ChewOnThis/e2k-e3k-systems/README.md

### Repository for ENGG2000/ENGG3000 Systems team
Working on code for sensors and bridge movement

#### Project:
    Contains the Arduino acceptable Project Code

#### Documentation:
    Psuedocode and File Function Separation
    Algorithm Flow Sequence Chart {Mermaid}

### Current Working Directory:
- MidSem
    - HTML
    - Motor Control
    - Traffic Light Control
    - Street Light Control
    - Button Control
    - UltraSonic Singular
    - UltraSonic Double
    - Webpage
        - HTML
        - ESP32
    - StateMachine
    - Project
        - Full Project
