ChewOnThis/e2k-e3k-systems/Documentation/ESP Pin Mapping Notes.docx

## Pins:

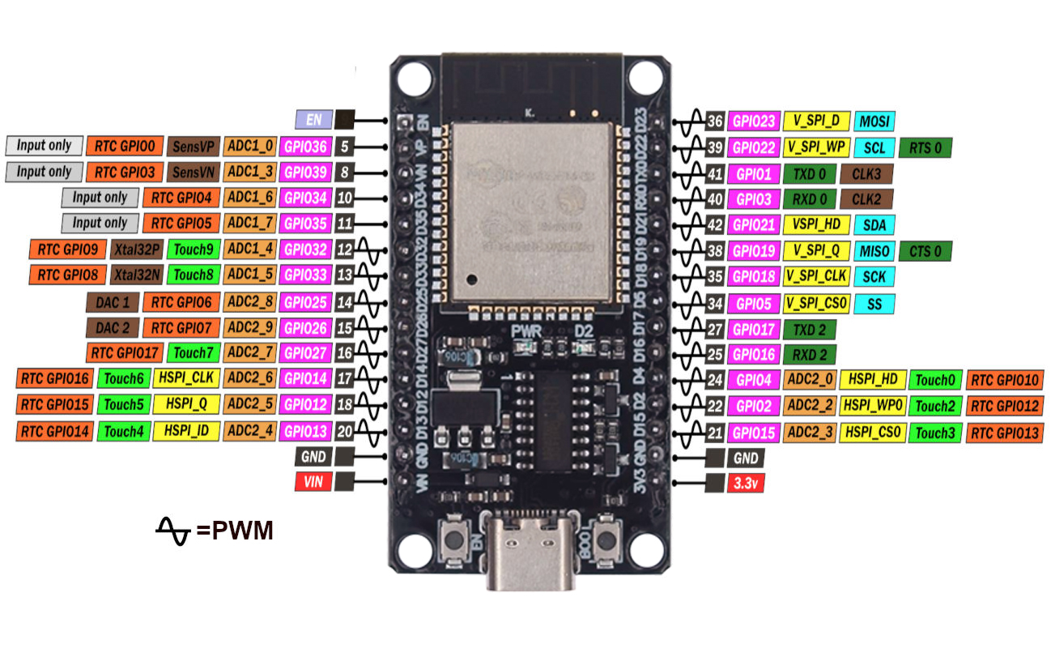
[picture p1: figure]

EN | D23
VP | D22
VN | TX0
D34 | RX0
D35 | D21
D32 | D19
D33 | D18
D25 | D5
D26 | D17
D27 | D16
D14 | D4
D12 | D2
D13 | D15
GND | GND
VIN | 3V3

Key:

| Input only (no pull-up/pull-down)
| Avoid
| Output only (onboard LED)
| ADC unavailable when Wi-fi is enabled
| State affects boot-up process

## Avoid:

- GPIO6
- GPIO7
- GPIO8
- GPIO9
- GPIO10
- GPIO11
  - Click for explanation (https://randomnerdtutorials.com/esp32-pinout-reference-gpios/)
- RX0
- TX0
  - Serial debugger pins
- GPIO2
  - LED on board acts as a very strong pull-down, since we’re using a pull-up approach for all buttons, this pin should only be used for outputs
  - Additionally, Chris uses the LED for debugging so try to avoid unless absolutely necessary
- GPIO5
- GPIO12
- GPIO15
  - Click for explanation (https://lastminuteengineers.com/esp32-pinout-reference/)

## Peripheral needs (MVP):

- Motor driver
  - 2x PWM channels (any GPIO pin)
- LEDS
  - 5x GPIO
- Switches
  - 3x GPIO (with pull-ups)

## Peripheral needs (full design):

- Motor driver
  - 2x PWM channels (any GPIO pin)
- LEDS
  - 6x GPIO
- Switches
  - 4x GPIO (with pull-ups)
- Buzzer
  - 1x GPIO
- Ultrasonics
  - 2x Inputs receive pins
  - 2x GPIO trigger pins

# Pins in use:

Connected to | Pins | | Connected to
| EN | D23 | E-Stop
Ultrasonic echo 2 | VP | D22 | Start button
Ultrasonic echo 1 | VN | TX0
Light sensor | D34 | RX0
| D35 | D21 | Status light
Ultrasonic trigger 2 | D32 | D19 | Piezo buzzer
Ultrasonic trigger 1 | D33 | D18 | Streetlight MOSFET
Car red | D25 | D5 | Driver board En
Car yellow | D26 | D17 | Limit switch 2
Car green | D27 | D16 | Limit switch 1
Boat red | D14 | D4
Driver board In2 | D12 | D2
Driver board In1 | D13 | D15
Driver board / 5V regulator Gnd | GND | GND
5V regulator | VIN | 3V3
