ChewOnThis/e2k-e3k-systems/Documentation/MVP Schematic Clean.png

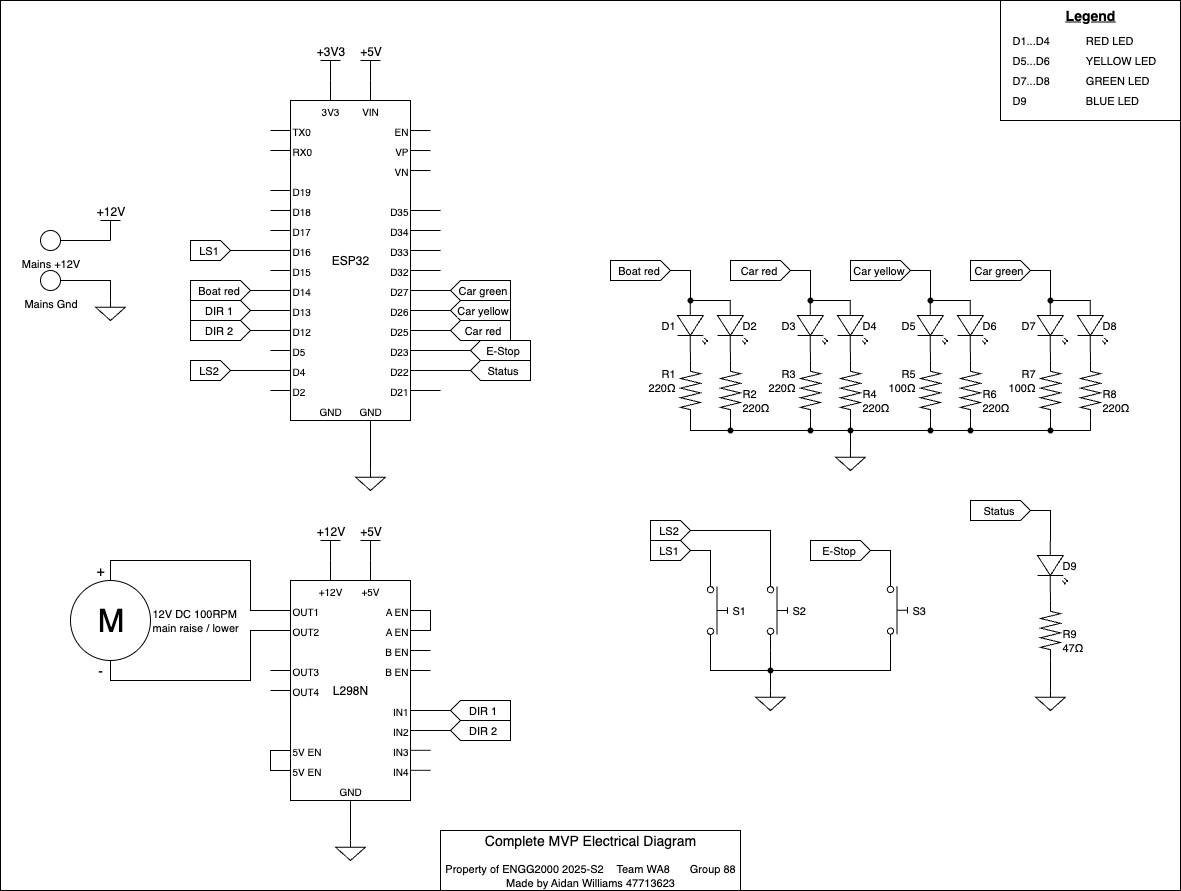
Documentation/MVP Schematic Clean.png
