ChewOnThis/e2k-e3k-systems/Documentation/Whole Bridge Schematic.png

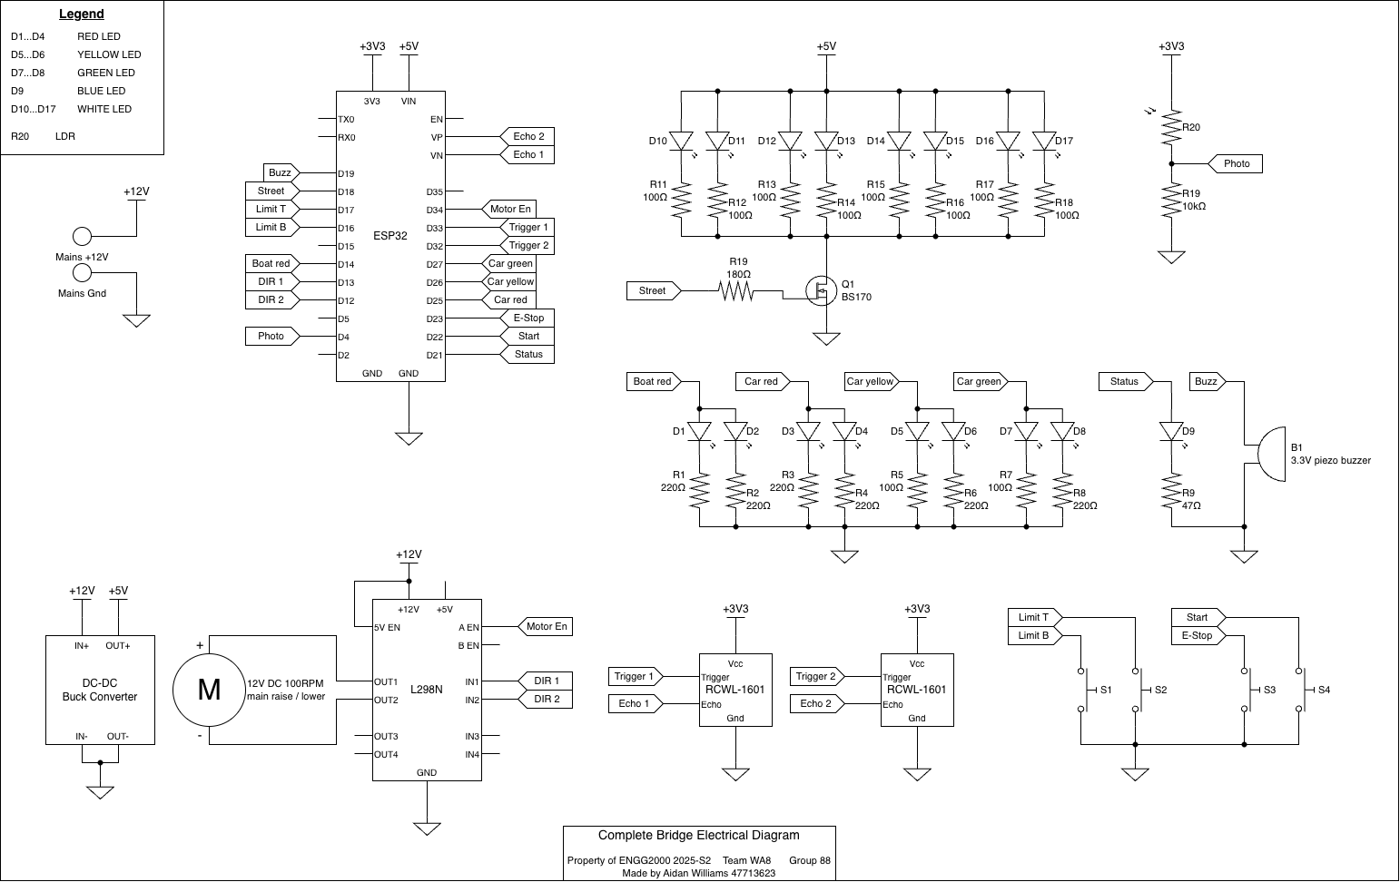
Documentation/Whole Bridge Schematic.png
