ChewOnThis/e2k-e3k-systems/psuedocode/ControlBridge/Diagrams/bridge states.png

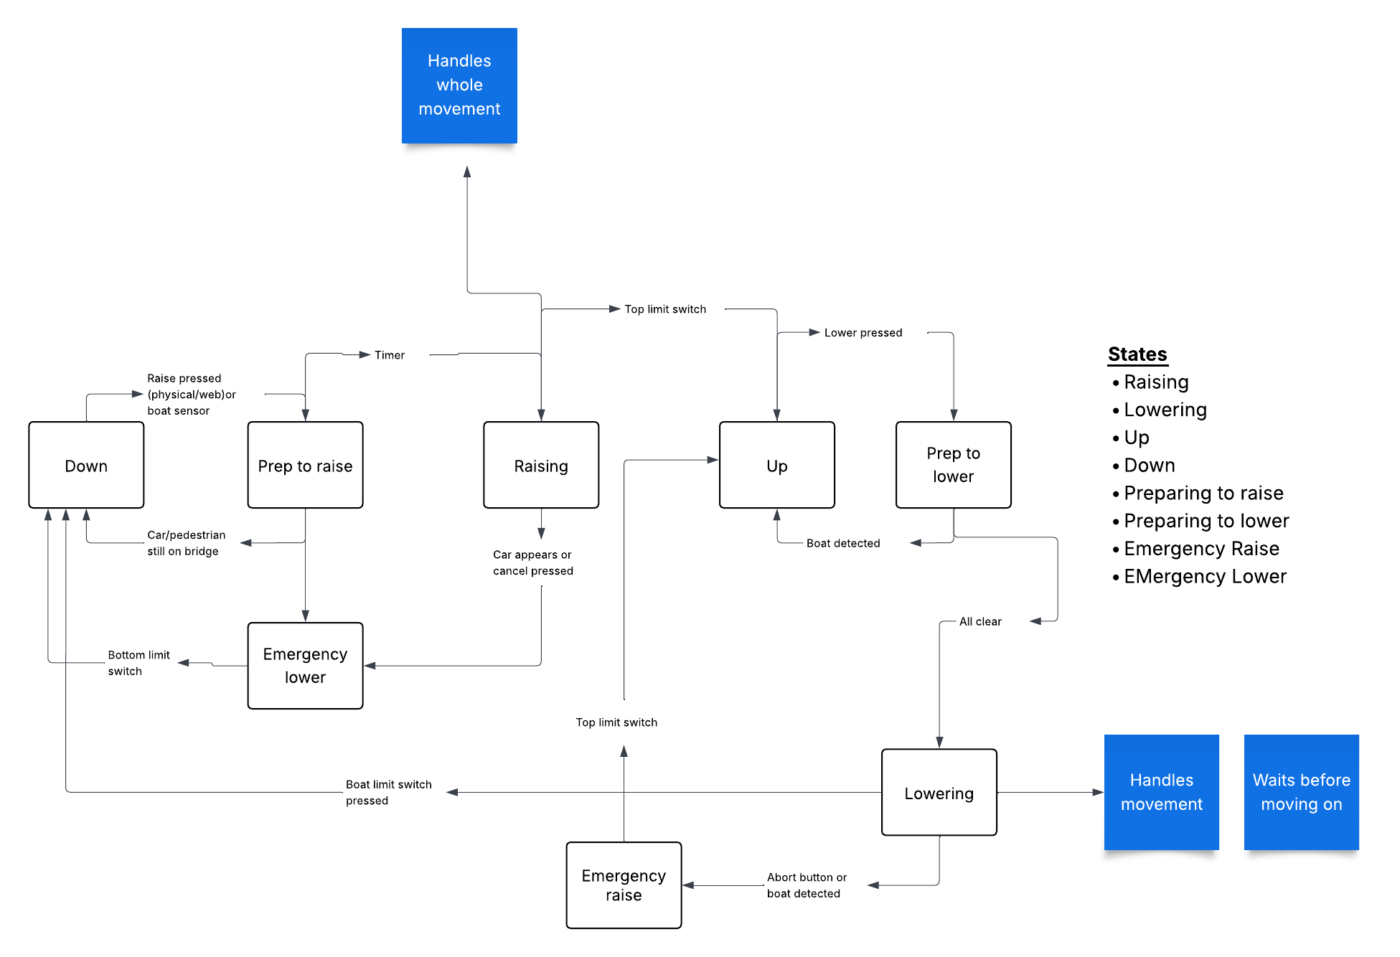
psuedocode/ControlBridge/Diagrams/bridge states.png
