ChewOnThis/e2k-e3k-systems/psuedocode/ControlBridge/Diagrams/down state.png

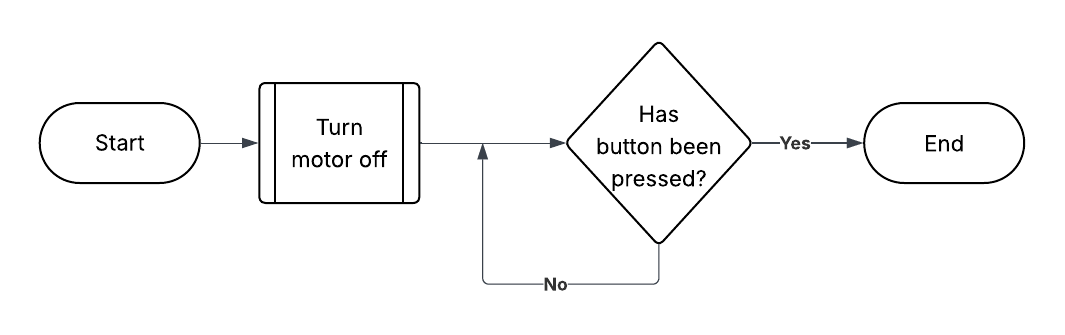
psuedocode/ControlBridge/Diagrams/down state.png
