ChewOnThis/e2k-e3k-systems/psuedocode/ControlBridge/Diagrams/emergency lowering state.png

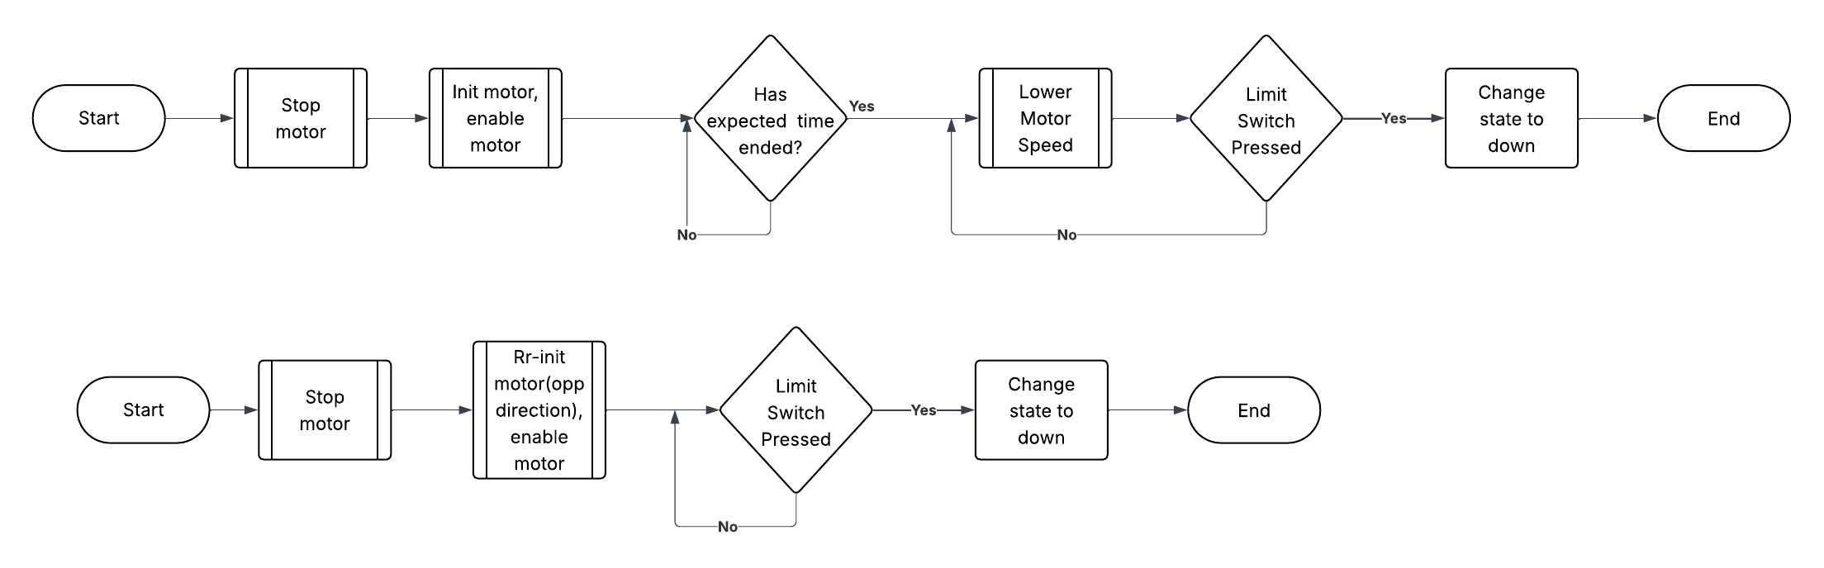
psuedocode/ControlBridge/Diagrams/emergency lowering state.png
