ChewOnThis/e2k-e3k-systems/psuedocode/ControlBridge/Diagrams/emergency raising state.png

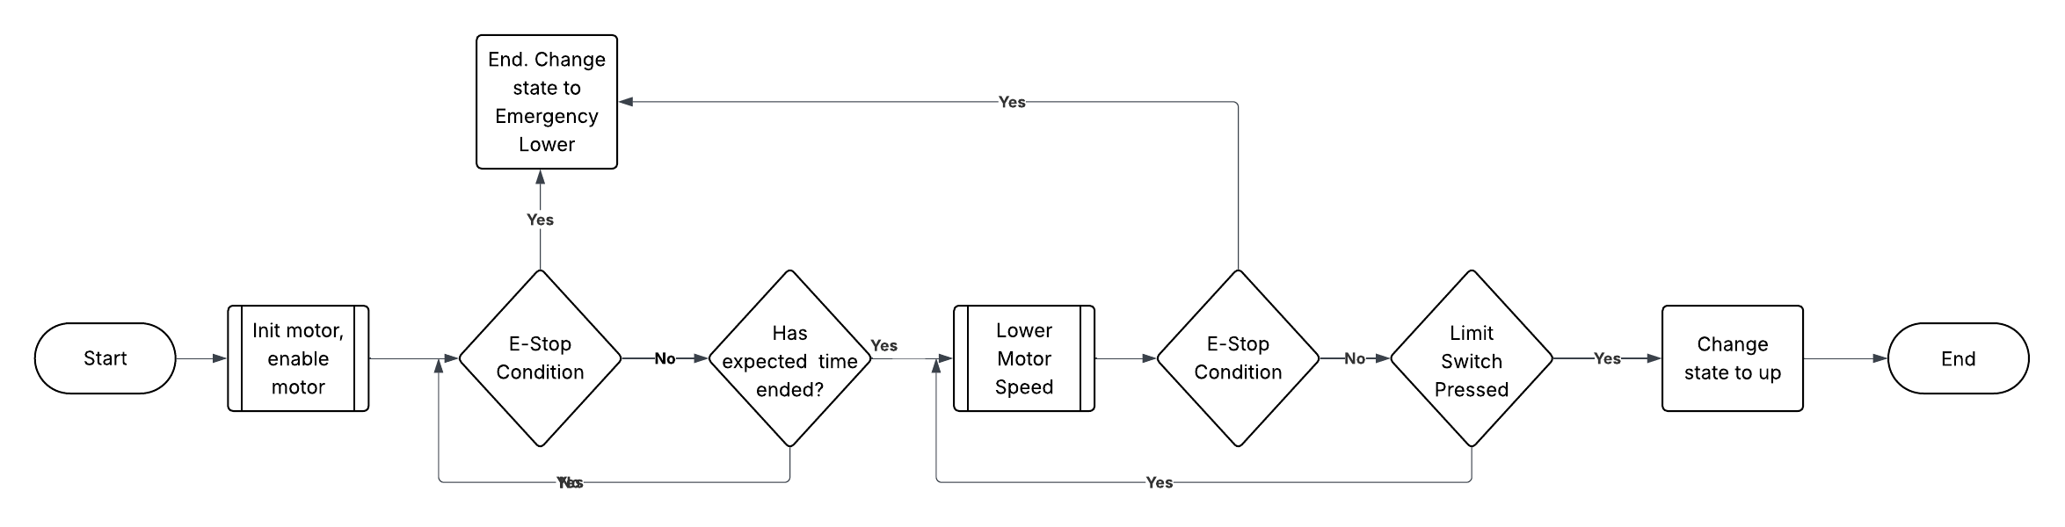
psuedocode/ControlBridge/Diagrams/emergency raising state.png
