ChewOnThis/e2k-e3k-systems/psuedocode/ControlBridge/Diagrams/prep to raise state.png

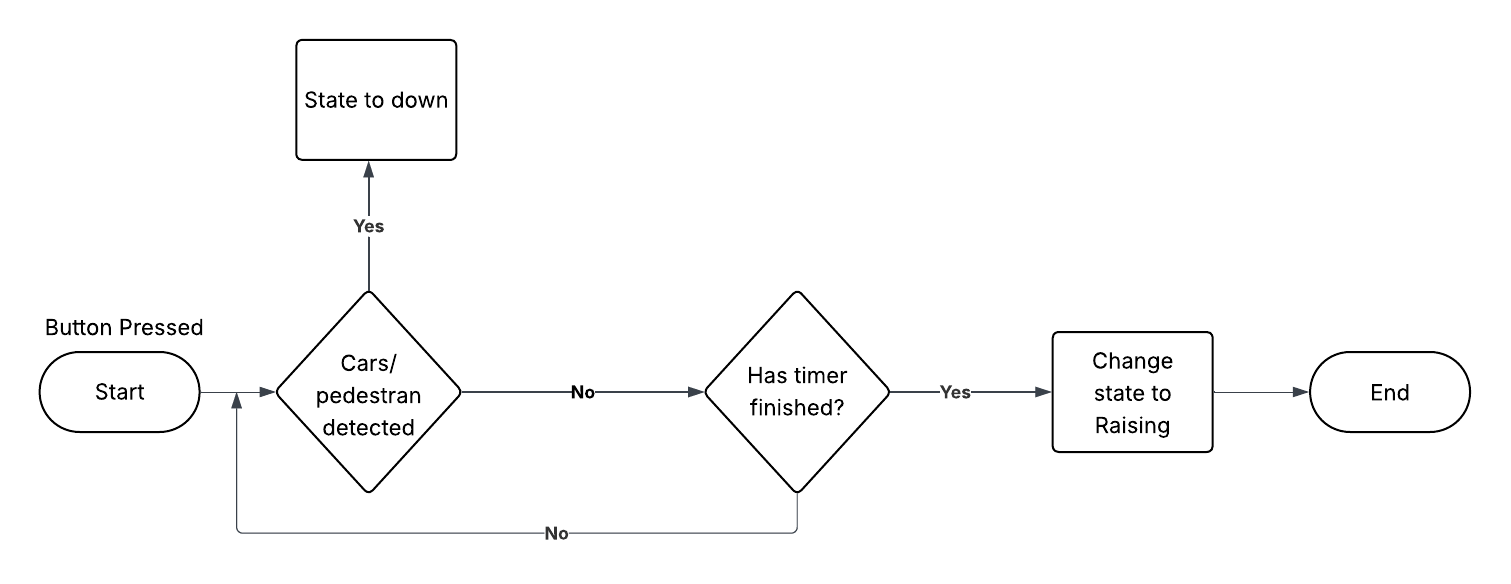
psuedocode/ControlBridge/Diagrams/prep to raise state.png
