ChewOnThis/e2k-e3k-systems/psuedocode/ControlBridge/Diagrams/Up State.png

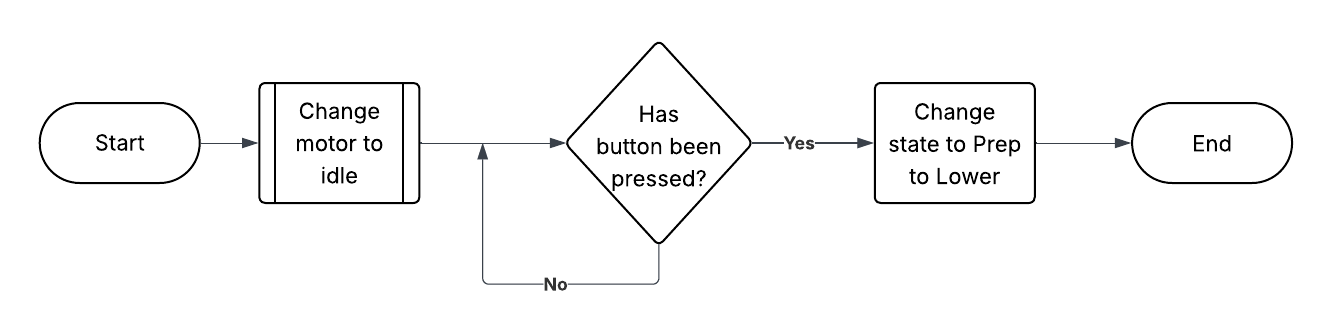
psuedocode/ControlBridge/Diagrams/Up State.png
