ChewOnThis/e2k-e3k-systems/testing/WebServer Testing/WebServer/GridLayout.html

# Team WA8 Single Leaf Bridge

## Wireless Control Panel

Team WA8 Wifi Control Web-Based GUI for AP Access to the ESP32 Microcontroller for Controller over subsystems of the ENGG2000/3000 Scale Model Bridge Design/Contruction Project

GitHub Repository (https://github.com/ChewOnThis/e2k-e3k-systems)
