ChewOnThis/e2k-e3k-systems/MidSem/Project/main.h

#ifndef MAIN_H
#define MAIN_H

#include <Arduino.h>
#include <TimerOne.h>
#include "WebPage.h"
#include "StateMachine.h"
#include "DCMotor.h"
#include "SonicSensor.h"
#include "TrafficLight.h"


#define Pin_Enable           5
#define Pin_DIR2            12
#define Pin_DIR1            13 
#define Pin_BoatLight       14
#define Pin_LS_Bottom       16
#define Pin_LS_Top          17
#define Pin_Street          18
#define Pin_Status          21
#define Pin_Buzzer          19
#define Pin_BridgeMove      22
#define Pin_EStop           23
#define Pin_TrafficRed      25
#define Pin_TrafficYellow   26
#define Pin_TrafficGreen    27
#define Pin_SonicTrigger_2  32
#define Pin_SonicTrigger_1  33
#define Pin_PhotoCell       34
#define Pin_SonicEcho_2     36
#define Pin_SonicEcho_1     39

#define MotorSpeed_Fast 
#define MotorSpeed_Slow

#define WebServer_PollingRate   1000 //ms
#define WebServer_SSID          "ESP32WA8"
#define WebServer_Password      "12345678"

extern TrafficModule traffic;
extern Sonic sonic1;
extern Sonic sonic2;
extern Motor motor ;
void initPins();
void disableMotor();
void initInterrupts();
void streetLights();
void sonics();
extern bridgeState currentState;
extern bool Manual;
extern bool EStop;
extern bool streetLightOn;
extern bool ultrasonics;
extern double sonic1Dist_cm;
extern double sonic2Dist_cm;

const int detection_distance = 30;


#endif
