ChewOnThis/e2k-e3k-systems/MidSem/Project/DCMotor.h

#ifndef DCMOTOR_H
#define DCMOTOR_H

#include <Arduino.h>

class Motor {
    private:
        uint8_t DrivePin;
        uint8_t DirectionPin;
        uint8_t EnablePin;
    public:
        Motor(uint8_t drive, uint8_t dir, uint8_t en);
        void init();
        void disable();
        void run(int pwm, int direction);
};

#endif
