ChewOnThis/e2k-e3k-systems/testing/Ultrasonic_example/Ultrasonic_example.ino

/* Credit:
 * https://projecthub.arduino.cc/Isaac100/getting-started-with-the-hc-sr04-ultrasonic-sensor-7cabe1
*/

const int trigPin = 9;  
const int echoPin = 10;

float duration, distance;  

void setup() {  
	pinMode(trigPin, OUTPUT);  
	pinMode(echoPin, INPUT);  
	Serial.begin(115200);  
}

void loop() {  
	digitalWrite(trigPin, LOW);  
	delayMicroseconds(2);  
	digitalWrite(trigPin, HIGH);  
	delayMicroseconds(10);  
	digitalWrite(trigPin, LOW);
  duration = pulseIn(echoPin, HIGH);
  distance = (duration*.0343)/2;
  Serial.print("Distance:");  
	Serial.println(distance);  
	delay(100);  
}
