ChewOnThis/e2k-e3k-systems/(commit log)

2025-08-20 reconfigured files for current design scheme
2025-08-27 Testing directory and file for ESP32 Development board
2025-08-27 State Flow Diagram
2025-09-06 fixed LED Control to AP Mode
    [Test1_Comms.ino, Test2_LEDControl.ino]
2025-09-09 Test 3 - AJAX/Polling led from esp to web on interval
2025-09-10 current pin configuration
2025-09-10 Added First Ultrasonic Test
2025-09-10 Added First Double Ultrasonic Test
2025-09-10 Added Second Dual Ultrasonic Test
2025-09-11 Test 4 : Webpage - New UI, Title, Name, Buttons, State Displays, Footer. ESP - Clean state handling for current Webpage
2025-09-11 Added Electrical Schematics
2025-09-11 Created electrical schematics
2025-09-11 Moved existing pin mapping
2025-09-17 Fixed LM298n pin names
2025-09-17 Added light sensor
2025-09-18 Added pin 2 to avoid list
2025-09-19 Fixed photocell circuit
2025-09-19 found out new pin restrictions
2025-10-02 Continued Development of new website layout/backend and begun development of core functionality of ultra sonic sensors
2025-10-08 Added function to disable motor
2025-10-17 Changed some pin mapping
2025-10-22 Create sample motor test
    Just a trail
2025-10-22 sample sensor testing
    tried for ESP32
2025-10-31 Fixed some pin mappings
2025-10-31 Week 12 Friday - State machine fixed, project compile, pin-remap, pin-rename, html responsive layout fix
    [DCMotor.cpp, StateMachine.cpp, StateMachine.h, Test4.ino, WebPage.h, main.cpp, main.h]
2025-11-01 Fixed limit switch pin labels
2025-11-03 working project loop, still need statusled, sttaus buzzer, web check, timing tweaking, ultrasonic detection dist
    [Double_Ultrasonic_V2.ino, StateMachine.cpp, StateMachine.h, main.cpp, main.h]
2025-11-03 Working loop state machine, ultrasonic dialed in
2025-11-04 Fixed blink function maybe
    [StateMachine.cpp]
2025-11-04 Fixed the blink function maybe 2
    [StateMachine.cpp]
2025-11-05 working statemachine with possible webpage fix
    [SonicSensor.h, StateMachine.cpp, TrafficLight.cpp, main.cpp, main.h]
2025-11-07 Finalised Pin Mapping
2025-11-07 Finalised bridge schematic
2025-11-07 Added power supply report
